TheSilentDefender/single_pair_ethernet_expansion_card/single_pair_ethernet_expansion_card.kicad_pcb

## KiCad design single_pair_ethernet_expansion_card.kicad_pcb (2025-02-26)

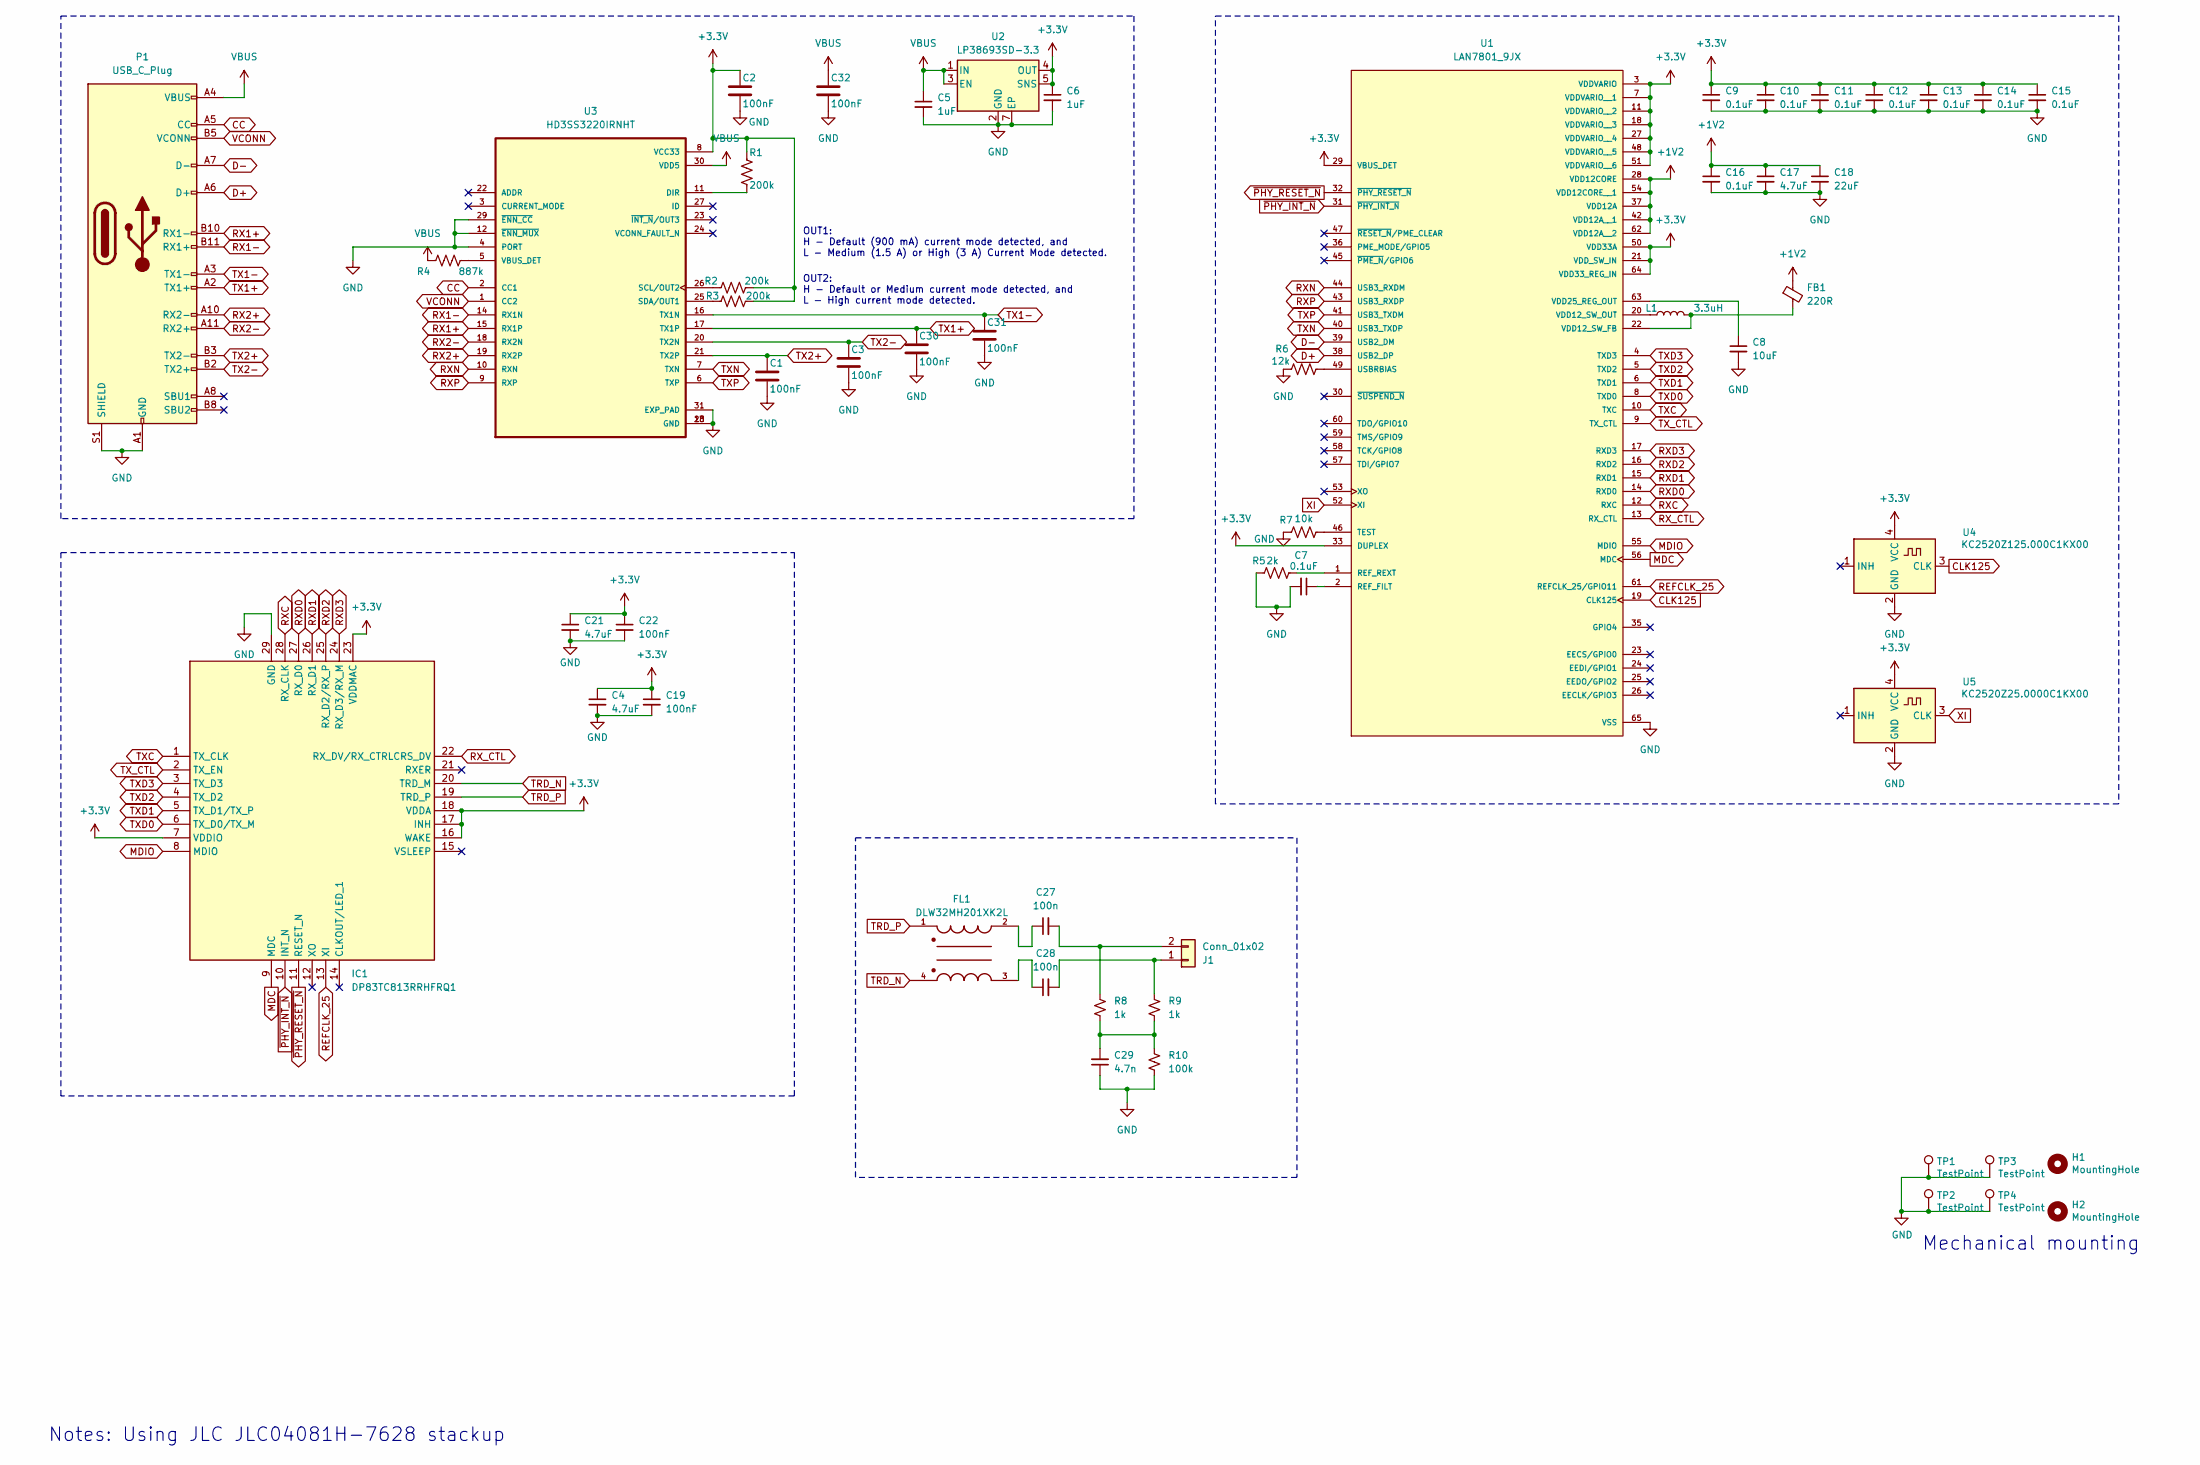
[picture p1: schematic single_pair_ethernet_expansion_card.kicad_sch]

Parts:
C1, C2, C3, C30, C31, C32: CC0402KRX5R7BB105; C_0201_0603Metric
C4, C17, C21: 4.7uF; C_0201_0603Metric
C5, C6: 1uF; C_0201_0603Metric
C7, C9, C10, C11, C12, C13, C14, C15, C16: 0.1uF; C_0201_0603Metric
C8: 10uF; C_0201_0603Metric
C18: 22uF; C_0201_0603Metric
C19, C22: 100nF; C_0201_0603Metric
C27, C28: 100n; C_0201_0603Metric
C29: 4.7n; C_0201_0603Metric
FB1: 220R; L_0201_0603Metric
FL1: DLW32MH201XK2L; FIL_DLW32MH201XK2L; PARTREV N/A
H1, H2: MountingHole; MountingHole_2.2mm_M2
IC1: DP83TC813RRHFRQ1; QFN50P400X500X100-29N-D; Mouser Part Number 595-DP83TC813RRHFRQ1
J1: Conn_01x02; JST_SH_SM02B-SRSS-TB_1x02-1MP_P1.00mm_Horizontal
L1: 3.3uH; L_0805_2012Metric
P1: USB_C_Plug; USB_C_Plug_Molex_105444
R1, R2, R3: RC0402JR-07200KL; R_0402_1005Metric
R4: RC0402FR-07887KL; R_0402_1005Metric
R5: 2k; R_0402_1005Metric
R6: 12k; R_0402_1005Metric
R7: 10k; R_0402_1005Metric
R8, R9: 1k; R_0402_1005Metric
R10: 100k; R_0402_1005Metric
TP1, TP2, TP3, TP4: TestPoint; TestPoint_Pad_1.5x1.5mm
U1: LAN7801_9JX; QFN50P900X900X100-65N_LAN7801_9JX; PARTREV DS00002123F
U2: LP38693SD-3.3; WSON-6-1EP_3x3mm_P0.95mm
U3: HD3SS3220IRNHT; QFN40P450X250X80-31N120X320; PART_REV C
U4: KC2520Z125.000C1KX00; Oscillator_SMD_Kyocera_KC2520Z-4Pin_2.5x2.0mm
U5: KC2520Z25.0000C1KX00; Oscillator_SMD_Kyocera_KC2520Z-4Pin_2.5x2.0mm

Connections:
+1V2: C16.1, C17.1, C18.1, FB1.1, U1.28 (VDD12CORE), U1.37 (VDD12A), U1.42 (VDD12A__1), U1.54 (VDD12CORE__1), U1.62 (VDD12A__2)
+3.3V: C2.1, C4.1, C6.1, C9.1, C10.1, C11.1, C12.1, C13.1, C14.1, C15.1, C19.1, C21.1, C22.1, IC1.7 (VDDIO), IC1.16 (WAKE), IC1.17 (INH), IC1.18 (VDDA), IC1.23 (VDDMAC), R1.1, R2.2, R3.2, U1.3 (VDDVARIO), U1.7 (VDDVARIO__1), U1.11 (VDDVARIO__2), U1.18 (VDDVARIO__3), U1.21 (VDD_SW_IN), U1.27 (VDDVARIO__4), U1.29 (VBUS_DET), U1.33 (DUPLEX), U1.48 (VDDVARIO__5), U1.50 (VDD33A), U1.51 (VDDVARIO__6), U1.64 (VDD33_REG_IN), U2.4 (OUT), U2.5 (SNS), U3.8 (VCC33), U4.4 (VCC), U5.4 (VCC)
CC: P1.A5 (CC), U3.2 (CC1)
CLK125: U1.19 (CLK125), U4.3 (CLK)
D+: P1.A6 (D+), U1.38 (USB2_DP)
D-: P1.A7 (D-), U1.39 (USB2_DM)
GND: C1.2, C2.2, C3.2, C4.2, C5.2, C6.2, C7.2, C8.2, C9.2, C10.2, C11.2, C12.2, C13.2, C14.2, C15.2, C16.2, C17.2, C18.2, C19.2, C21.2, C22.2, C29.1, C30.2, C31.2, C32.2, IC1.29 (GND), J1.MP, P1.A1 (GND), P1.A12 (GND), P1.B1 (GND), P1.B12 (GND), P1.S1 (SHIELD), R5.1, R6.1, R7.1, R10.2, TP1.1, TP2.1, TP3.1, TP4.1, U1.65 (VSS), U2.2 (GND), U2.7 (EP), U3.4 (PORT), U3.12 (~ENN_MUX), U3.13 (GND), U3.28 (GND), U3.29 (~ENN_CC), U3.31 (EXP_PAD), U4.2 (GND), U5.2 (GND)
MDC: IC1.9 (MDC), U1.56 (MDC)
MDIO: IC1.8 (MDIO), U1.55 (MDIO)
unnamed: C27.1, FL1.2
unnamed: C28.1, FL1.3
unnamed: C29.2, R8.2, R9.2, R10.1
unnamed: C28.2, J1.1, R9.1
unnamed: C27.2, J1.2, R8.1
unnamed: C7.1, U1.2 (REF_FILT)
unnamed: R5.2, U1.1 (REF_REXT)
unnamed: R7.2, U1.46 (TEST)
unnamed: R6.2, U1.49 (USBRBIAS)
unnamed: FB1.2, L1.2, U1.22 (VDD12_SW_FB)
unnamed: L1.1, U1.20 (VDD12_SW_OUT)
unnamed: C8.1, U1.63 (VDD25_REG_OUT)
unnamed: R1.2, U3.11 (DIR)
unnamed: R2.1, U3.26 (SCL/OUT2)
unnamed: R3.1, U3.25 (SDA/OUT1)
unnamed: R4.2, U3.5 (VBUS_DET)
REFCLK_25: IC1.13 (XI), U1.61 (REFCLK_25/GPIO11)
RX1+: P1.B10 (RX1-), U3.15 (RX1P)
RX1-: P1.B11 (RX1+), U3.14 (RX1N)
RX2+: P1.A10 (RX2-), U3.19 (RX2P)
RX2-: P1.A11 (RX2+), U3.18 (RX2N)
RXC: IC1.28 (RX_CLK), U1.12 (RXC)
RXD0: IC1.27 (RX_D0), U1.14 (RXD0)
RXD1: IC1.26 (RX_D1), U1.15 (RXD1)
RXD2: IC1.25 (RX_D2/RX_P), U1.16 (RXD2)
RXD3: IC1.24 (RX_D3/RX_M), U1.17 (RXD3)
RXN: U1.44 (USB3_RXDM), U3.10 (RXN)
RXP: U1.43 (USB3_RXDP), U3.9 (RXP)
RX_CTL: IC1.22 (RX_DV/RX_CTRLCRS_DV), U1.13 (RX_CTL)
TRD_N: FL1.4, IC1.20 (TRD_M)
TRD_P: FL1.1, IC1.19 (TRD_P)
TX1+: C30.1, P1.A2 (TX1+), U3.17 (TX1P)
TX1-: C31.1, P1.A3 (TX1-), U3.16 (TX1N)
TX2+: C1.1, P1.B3 (TX2-), U3.21 (TX2P)
TX2-: C3.1, P1.B2 (TX2+), U3.20 (TX2N)
TXC: IC1.1 (TX_CLK), U1.10 (TXC)
TXD0: IC1.6 (TX_D0/TX_M), U1.8 (TXD0)
TXD1: IC1.5 (TX_D1/TX_P), U1.6 (TXD1)
TXD2: IC1.4 (TX_D2), U1.5 (TXD2)
TXD3: IC1.3 (TX_D3), U1.4 (TXD3)
TXN: U1.40 (USB3_TXDP), U3.7 (TXN)
TXP: U1.41 (USB3_TXDM), U3.6 (TXP)
TX_CTL: IC1.2 (TX_EN), U1.9 (TX_CTL)
VBUS: C5.1, C32.1, P1.A4 (VBUS), P1.A9 (VBUS), P1.B4 (VBUS), P1.B9 (VBUS), R4.1, U2.1 (IN), U2.3 (EN), U2.6 (IN), U3.30 (VDD5)
VCONN: P1.B5 (VCONN), U3.1 (CC2)
XI: U1.52 (XI), U5.3 (CLK)
~PHY_INT_N: IC1.10 (INT_N), U1.31 (~PHY_INT_N)
~PHY_RESET_N: IC1.11 (RESET_N), U1.32 (~PHY_RESET_N)

Notes on the sheet:
OUT2: H - Default or Medium current mode detected, and L - High current mode detected.
Notes: Using JLC JLC04081H-7628 stackup
Mechanical mounting
OUT1: H - Default (900 mA) current mode detected, and L - Medium (1.5 A) or High (3 A) Current Mode detected.

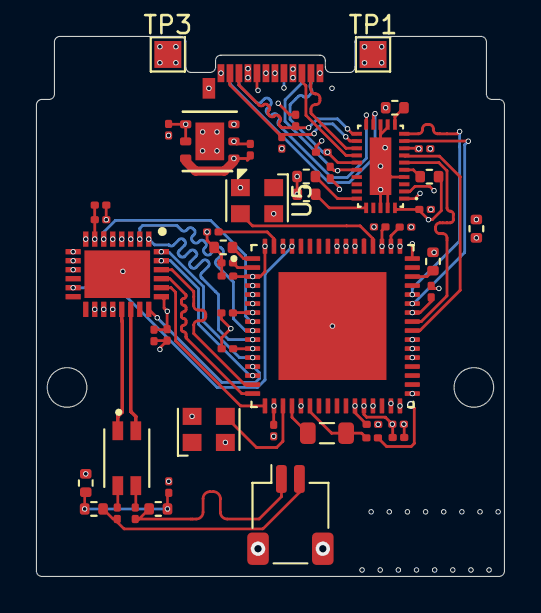
[picture p2: board single_pair_ethernet_expansion_card.kicad_pcb from above]

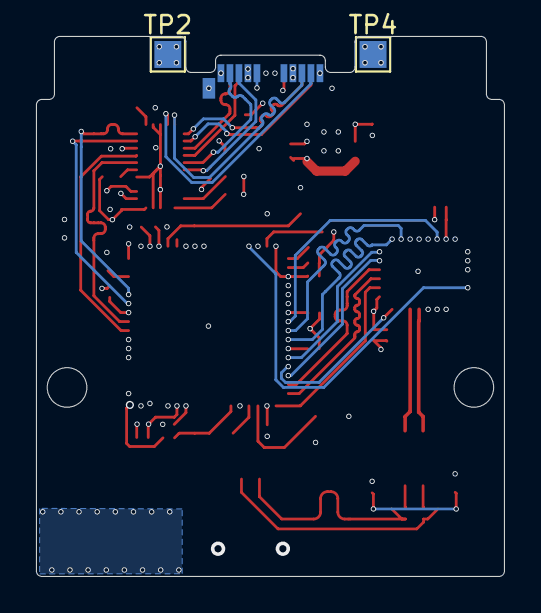
[picture p3: board single_pair_ethernet_expansion_card.kicad_pcb from below]

Board: 4 copper layers, 26.0 x 30.0 mm, 54 parts (2 on the bottom side), 57 nets.
