TheSilentDefender/single_pair_ethernet_expansion_card/(notices)

Notices in the files:
single_pair_ethernet_expansion_card.sch:
This work is licensed under a Creative Commons Attribution 4.0 International License
